Dombearx/homarMic/docs/img/case-speaker.png

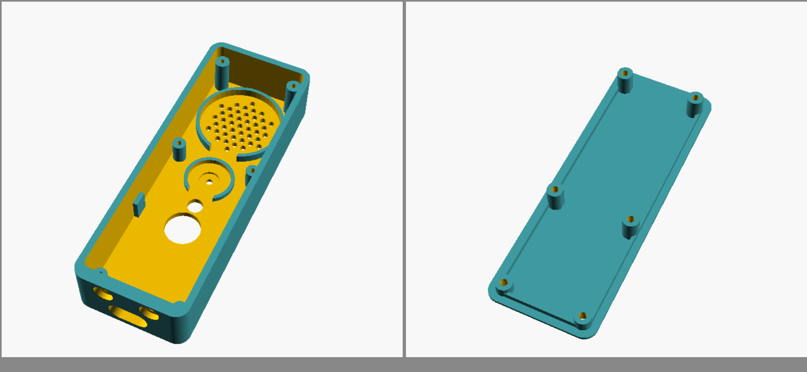
docs/img/case-speaker.png
