Dombearx/homarMic/docs/img/dock.png

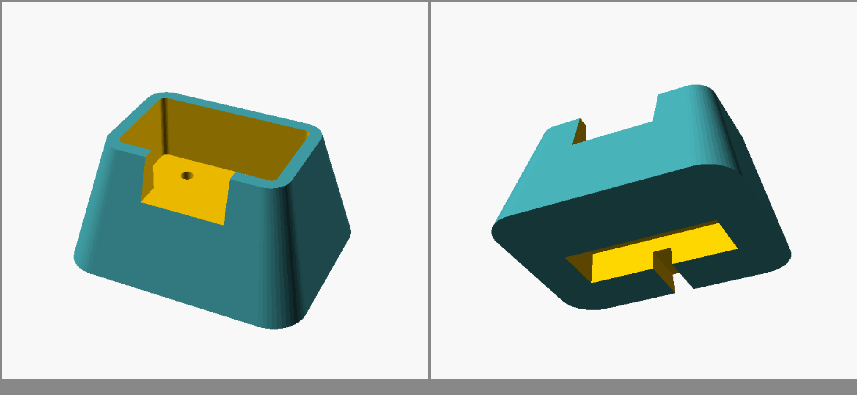
docs/img/dock.png
