Dombearx/homarMic/docs/img/pcb-dock.png

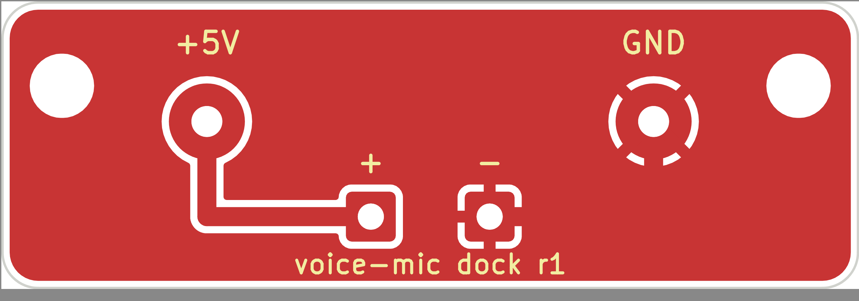
docs/img/pcb-dock.png
