Dombearx/homarMic/case/stl/lid.stl

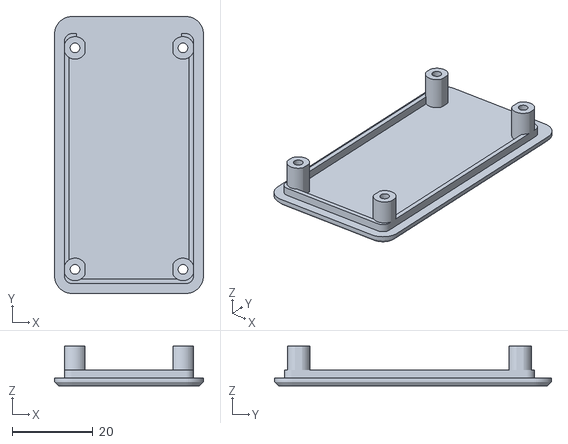
[picture p6: CAD file, 2026-11-09]
case/stl/lid.stl
37.0 x 68.8 x 9.90
