Dombearx/homarMic/case/stl/dock.stl

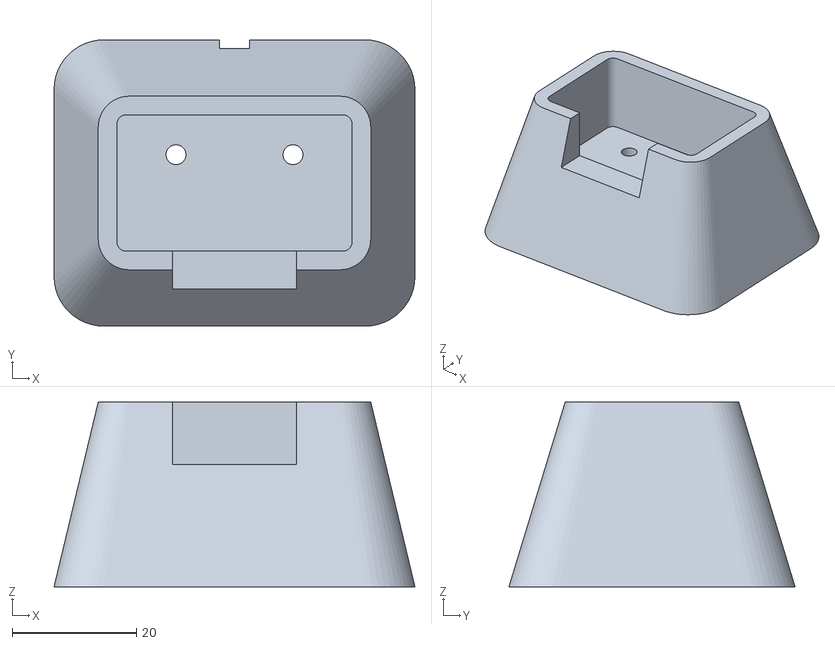
[picture p7: CAD file, 2026-11-09]
case/stl/dock.stl
58.0 x 46.0 x 29.7
