Dombearx/homarMic/case/stl/tub.stl

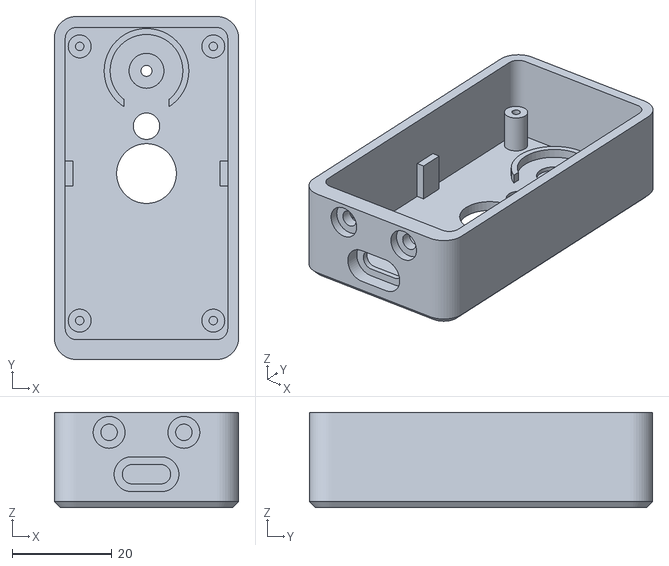
[picture p8: CAD file, 2026-11-09]
case/stl/tub.stl
37.0 x 68.8 x 19.1
