Dombearx/homarMic/case/stl/button.stl

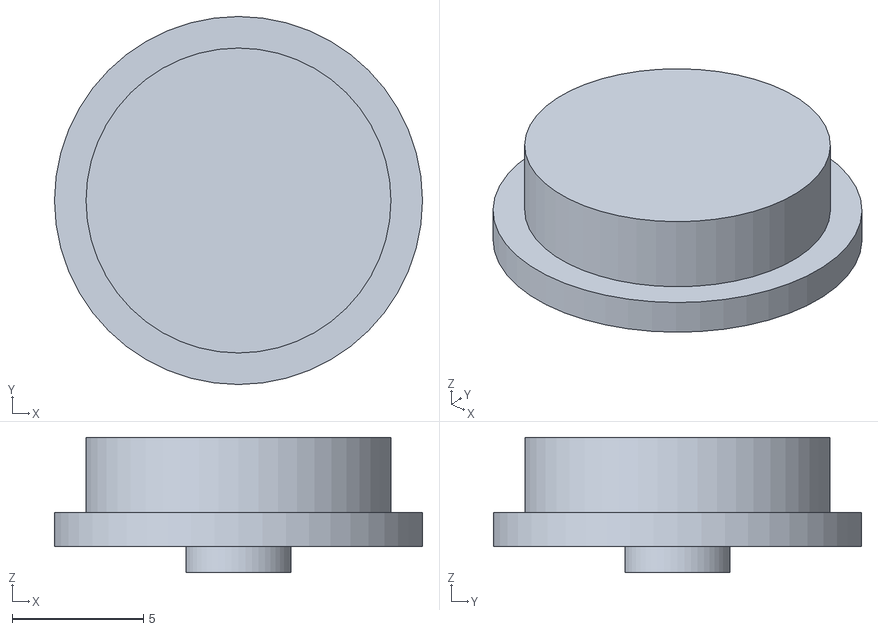
[picture p9: CAD file, 2026-11-09]
case/stl/button.stl
14.0 x 14.0 x 5.14
