Dombearx/homarMic/case/stl/tub-speaker.stl

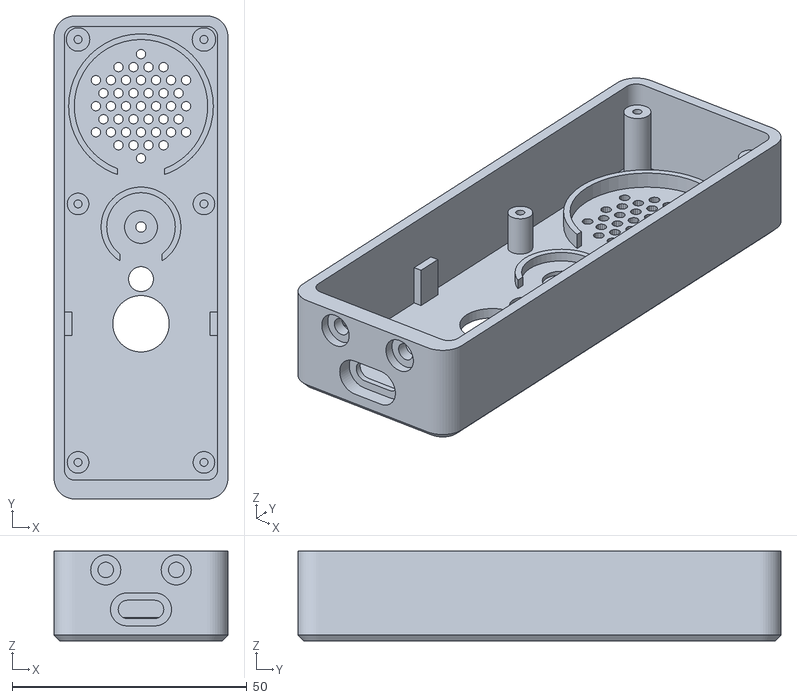
[picture p10: CAD file, 2026-11-09]
case/stl/tub-speaker.stl
37.0 x 102.8 x 19.1
