Dombearx/homarMic/case/stl/lid-speaker.stl

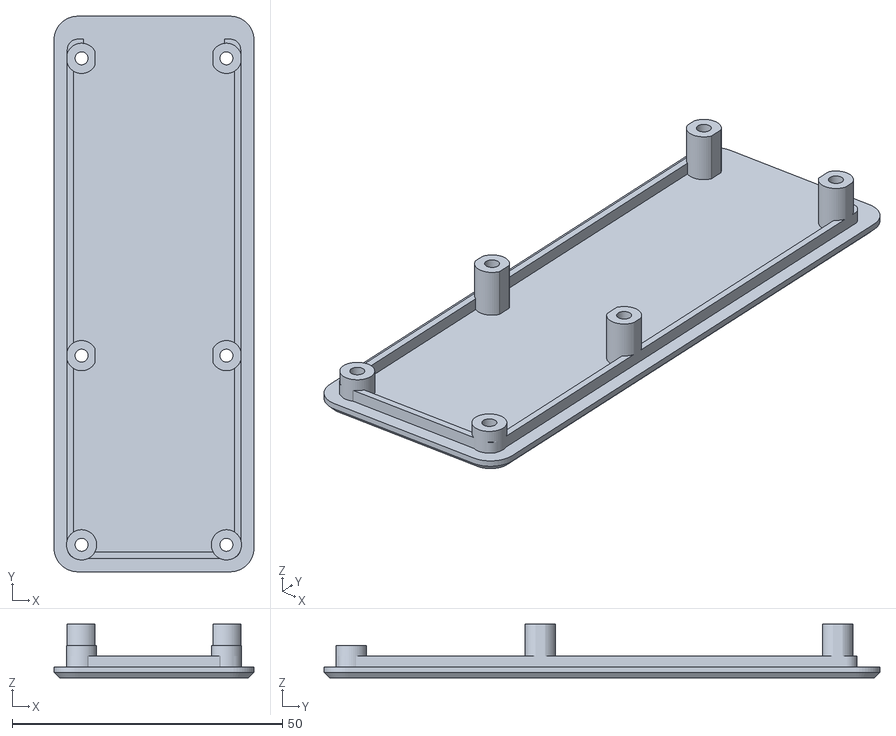
[picture p11: CAD file, 2026-11-09]
case/stl/lid-speaker.stl
37.0 x 102.8 x 9.90
