Dombearx/homarMic/pcb/voice-mic-dock.kicad_pcb

## KiCad design pcb/voice-mic-dock.kicad_pcb (2026-11-09)

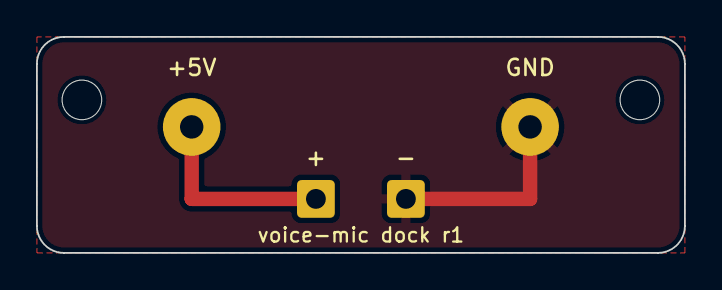
[picture p12: board voice-mic-dock.kicad_pcb from above]

Board: 2 copper layers, 36.0 x 12.0 mm, 5 parts (0 on the bottom side), 2 nets.

Parts:
H1, H2: M2; MountingHole_2.2mm_M2
J1: +5V; SolderWire-0.5sqmm_1x01_D0.9mm_OD2.1mm
J2: GND; SolderWire-0.5sqmm_1x01_D0.9mm_OD2.1mm
P1: pogo x2

Connections:
+5V: J1.1, P1.1
GND: J2.1, P1.2
