Dombearx/homarMic/pcb/voice-mic.kicad_pcb

## KiCad design pcb/voice-mic.kicad_pcb (2026-11-09)

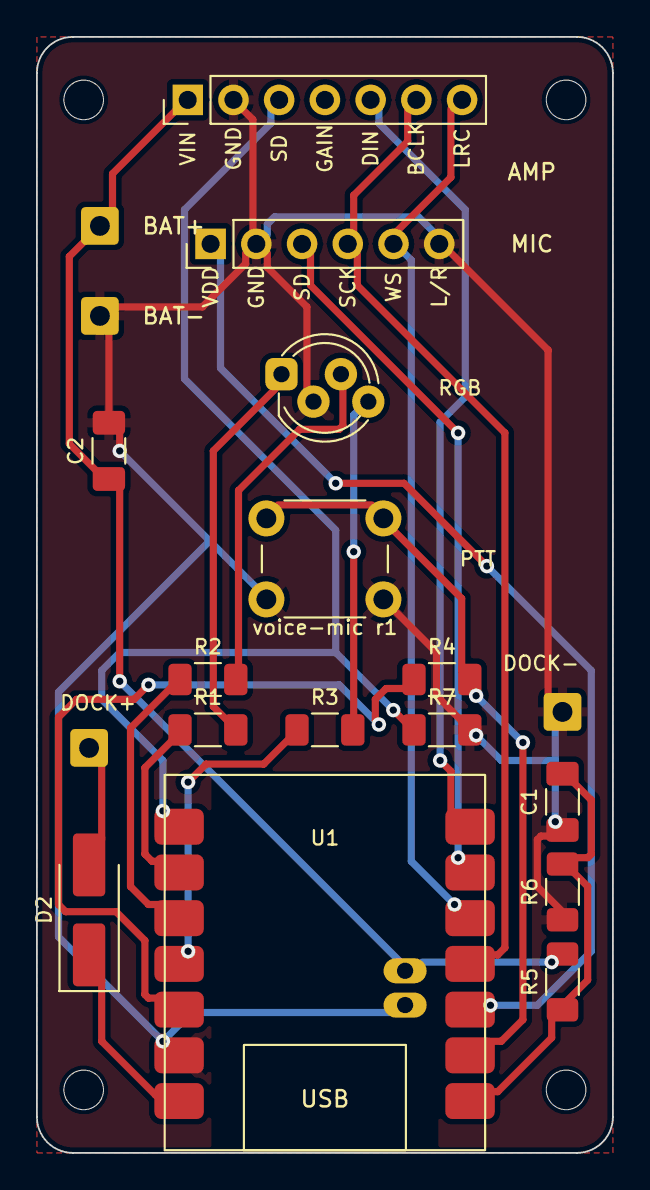
[picture p13: board voice-mic.kicad_pcb from above]

Board: 2 copper layers, 32.0 x 62.0 mm, 23 parts (0 on the bottom side), 19 nets.

Parts:
C1: 100n; C_1206_3216Metric_Pad1.33x1.80mm_HandSolder
C2: 10u; C_1206_3216Metric_Pad1.33x1.80mm_HandSolder
D1: RGB 5mm wsp. katoda; LED_D5.0mm-4_RGB_Staggered_Pins
D2: SS14; D_SMA_Handsoldering
H1, H2, H3, H4: M2; MountingHole_2.2mm_M2
J1: INMP441; PinHeader_1x06_P2.54mm_Vertical
J2: MAX98357A; PinHeader_1x07_P2.54mm_Vertical
J3: BAT+; SolderWire-0.5sqmm_1x01_D0.9mm_OD2.1mm
J4: DOCK+; SolderWire-0.5sqmm_1x01_D0.9mm_OD2.1mm
J5: DOCK-; SolderWire-0.5sqmm_1x01_D0.9mm_OD2.1mm
J6: BAT-; SolderWire-0.5sqmm_1x01_D0.9mm_OD2.1mm
R1: 470R; R_1206_3216Metric_Pad1.30x1.75mm_HandSolder
R2, R3: 220R; R_1206_3216Metric_Pad1.30x1.75mm_HandSolder
R4: 100k; R_1206_3216Metric_Pad1.30x1.75mm_HandSolder
R5, R6: 470k; R_1206_3216Metric_Pad1.30x1.75mm_HandSolder
R7: 10k; R_1206_3216Metric_Pad1.30x1.75mm_HandSolder
SW1: 6x6x5; SW_PUSH_6mm_H5mm
U1: XIAO ESP32-S3

Connections:
+3V3: R4.1, U1.12
AMP_DIN: J2.5, U1.7
AMP_SD: J2.3, R7.1, U1.8
BAT_SENSE: C1.2, R5.1, R6.2, U1.1
BTN: R4.2, SW1.1, U1.2
DOCK_P: D2.2, J4.1
GND: C1.1, C2.2, D1.2, J1.2, J1.6, J2.2, J5.1, J6.1, R6.1, R7.2, SW1.2, U1.13, U1.24
I2S_BCLK: J1.4, J2.6, U1.4
I2S_WS: J1.5, J2.7, U1.5
LED_B: R3.1, U1.11
LED_BA: D1.4, R3.2
LED_G: R2.1, U1.10
LED_GA: D1.3, R2.2
LED_R: R1.1, U1.9
LED_RA: D1.1, R1.2
MIC_PWR: J1.1, U1.3
MIC_SD: J1.3, U1.6
VBAT: C2.1, J2.1, J3.1, R5.2, U1.23
VBUS: D2.1, U1.14
